Taunt-byte/UNISAL-ESP32/README.md

 # ESTAÇÃO METEOROLÓGICA COM PREVISÃO POR PRESSÃO ATMOSFÉRICA
